paddygoat/Weather-Station/README.md

# Weather-Station
Low power LoRa weather station with 'professional' wind instruments

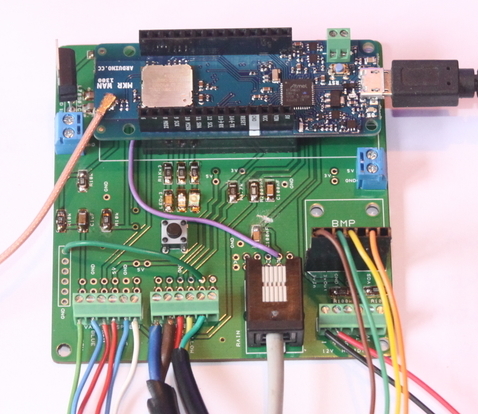
[picture p1: Arduino/weatherstation.jpg]

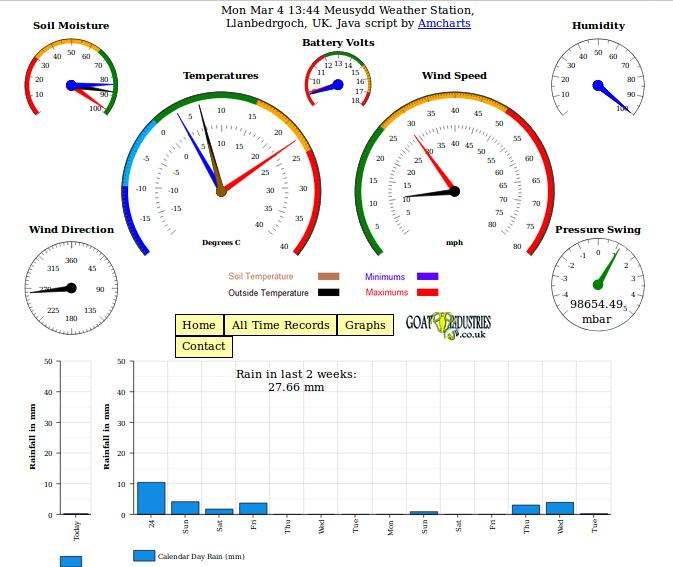
[picture p2: dials02.jpg]
