paddygoat/Weather-Station/PCB/README.md

.PCB file opens with 'Design Spark' software.

Weather station Tx can be used without Raspberry Pi or the Rx version if there is LoRa gateway in the locality.

The Rx PCB is for another Arduino 1300 LORAWAN that interfaces with 2G FONA module for Tx to interwebs.
