paddygoat/Weather-Station/server files/readMe.md

A web server with MYSQL and PHP capablities can be configured to present the GUI as seen at: 

http://www.goatindustries.co.uk/weather2/


Please check Amcharts license for terms of use.
