paddygoat/Weather-Station/server files/database_structure.png

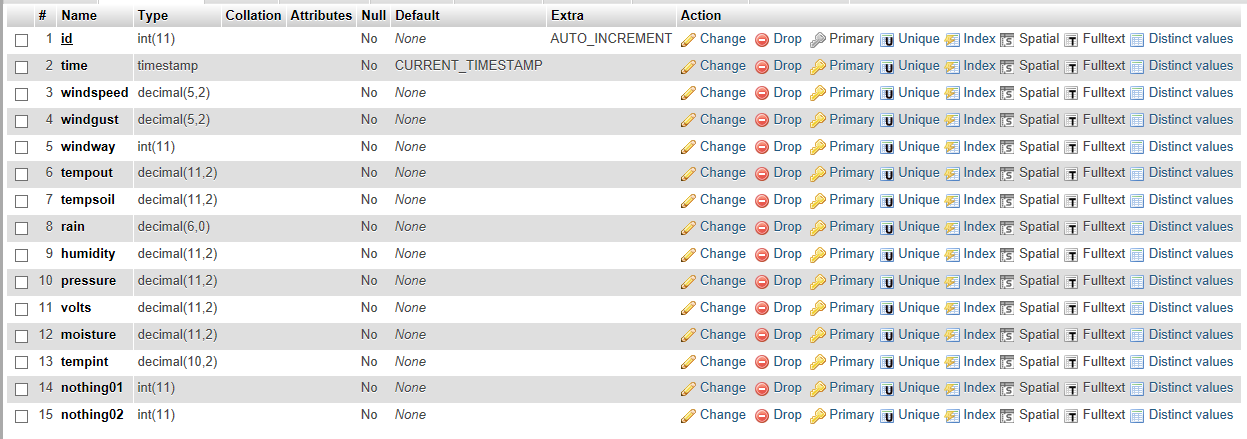
server files/database_structure.png
