paddygoat/Weather-Station/(threads)

Thread 1 (2020-11-11):

schematics

yanalp73, 2020-11-11:
Hello
Very interesting as a project
Is it possible to see the electronic diagram because I can only find the pcb
Thank you

gobotain, 2020-11-19:
Yes, pls make final version, incl schematics, bom etc.  Thanks

yanalp73, 2020-11-19:
Hello, where is the final version ? In PCB there is V4. But is only PCB, not schematics. Thanks

gobotain, 2020-11-19:
I'm looking at the commits on Arduino/Weather_station_V4.ino and some have/haven't been implemented in the .ino file.  Starting to lose faith in this project.

gobotain, 2020-11-20:
https://www.instructables.com/Arduino-GPRS-Weather-Station-Part-1/
