paddygoat/Weather-Station/(list of files, drawings)

Other design files:
PCB/Weather station 3_feather01.pcb
PCB/Weather station 3_Rx.pcb
PCB/Weather station 3_Tx.pcb
PCB/Weather station 4_feather01.pcb
PCB/Weather station 5 Heltech ESP32 LoRa.pcb
