paddygoat/Weather-Station/Arduino/windSpeed.cpp

#include <Arduino.h>
#include "counters.h"

unsigned long frequency;
float correction =0;
double runningTotal =0;

float knots =0.00;
float windSpeedValue =0.00;
float knotsMax =0.00;
float knotsAv =0.00;
float previousKnotsAv = 0.00;

float knotsDec =0.1;
float knotsMaxDec =0.1;
float knotsAvDec =0.1;

int frequencyInt;
int knotsInt;
int knotsAvInt;
int knotsMaxInt; 

int knotsDecInt;
int knotsMaxDecInt;
int knotsAvDecInt;

float previousKnots =0;
float calibration = 1.0047;    // (46.62 / 46.4)

float knotsRatio =0;
int error =0;
int zLog =0;
int windSpeedPin = 6;

void windSpeedSetup()
{

}
    
void windSpeed()
{
  //Serial.print(" ..pulseIn is next.. ");
  noInterrupts();                                                 // Stops rain guage from interupting pulsein.NB. The guage does poll twice.
  frequency = 500000/pulseIn(windSpeedPin,HIGH,500000);                     // was 5000000
  interrupts();
  if (frequency < 0){frequency=0;}    
  int correction =0;
  int adjustments();

  knots = (frequency * calibration /10) + correction + 0.1;
  windSpeedValue = knots;
  if (z==-1)
  {
    previousKnots = knots;
  }
  if (z==1)
  {
    zLog=0;
  }
  if ( z==25)
  {
    previousKnotsAv = knotsAv;                                                                // Helps filter work properly.
  }
  knotsRatio = knots/previousKnots;
  
  if( (previousKnots < 5) && (knotsRatio > 2.5) && (previousKnotsAv < 5) && (knots > 5) )                    // Filter out some weird readings at low speeds. PreviousK... used to be 3.
  {
    error =1;
    zLog = z;
    Serial.print("knots ratio:  ");Serial.print(knotsRatio);
    Serial.print("     knots:  ");Serial.print(knots);
    Serial.println("  ..... POSSIBLE ERROR DETECTED !! ..... NOW TRYING TO CORRECT.....");
    knots = previousKnots;
    Serial.print("     new knots:  ");Serial.print(knots);
    Serial.println("  .......... CORRECTED ??.....");
  }
  
  if(previousKnots < 5)
  {
    //delay(5000);                              // Allows pulseIn to catch up with itself? No - interfers with calback. 
  }
  previousKnots = knots;
  z++;
  

  if (knots > knotsMax)
  {
    knotsMax = knots;
  }
  
  runningTotal = runningTotal + knots;
  if(z==1)
  {
    runningTotal = knots;                              // Reset running total and max wind gust (knotsMax).
    knotsMax = knots;
  }
  
  knotsAv = runningTotal / z;
  if(knots > 0)
  {
    int beepFreq = ((int)knots * 10)+300;
    //Serial.print("beepFreq: ");Serial.println(beepFreq); 
    //tone(3,beepFreq,150);
  }
  Serial.print("Z: ");Serial.print(z);  
  Serial.print("    Knots: ");Serial.print(knots);
  Serial.print("    Knots ratio:  ");Serial.print(knotsRatio);
  Serial.print("    Previous knots av:  ");Serial.print(previousKnotsAv);
  //Serial.print("    Av wind speed: ");Serial.print(knotsAv);  
  Serial.print("    Max wind gust: ");Serial.print(knotsMax);   
  Serial.print("   LAST ERROR DETECTED at Z=  ");Serial.println(zLog);
  //Serial.print("   Running total: ");Serial.println(runningTotal);
  //Serial.print("Z: ");Serial.println(z);
}
void adjustments()
{   
    if ((frequency >=1) && (frequency <=100)) {correction = 0.20;}
    if ((frequency >100) && (frequency <=200)) {correction = 0.10;}
    if ((frequency >200) && (frequency <=300)) {correction = -0.25;}
    if ((frequency >300) && (frequency <=400)) {correction = -0.60;}
    if ((frequency >400) && (frequency <=500)) {correction = -1;}
    if ((frequency >500) && (frequency <=600)) {correction = -1.4;}
    if ((frequency >600) && (frequency <=700)) {correction = -1.75;}
    if ((frequency >700) && (frequency <=800)) {correction = -2;}
    if ((frequency >800) && (frequency <=900)) {correction = -2.20;}
    if ((frequency >900) && (frequency <=1000)) {correction = -2.35;}
    if ((frequency >1000) && (frequency <=1100)) {correction = -2.40;}
    if ((frequency >1100) && (frequency <=1200)) {correction = -2.50;}
    if ((frequency >1200) && (frequency <=1300)) {correction = -2.50;}
    if ((frequency >1300) && (frequency <=1400)) {correction = -2.50;}
    if ((frequency >1400) && (frequency <=1500)) {correction = -2.45;}
    if ((frequency >1500) && (frequency <=1600)) {correction = -2.40;}  
}
