paddygoat/Weather-Station/Glasshouse/batteryVolts.cpp

#include <Arduino.h>
#include "counters.h"

float volts=0;
float batteryVoltsValue =0;
float totalVolts;

//A3 is analogue in.

void batteryVolts()
{
    int sensorReading = analogRead(A3);
    batteryVoltsValue = sensorReading/28.81;
    //volts = analogRead(A3)/28.81;  
    //if (z>0)
    //{
    //  totalVolts = (totalVolts + volts);
    //  batteryVoltsValue = totalVolts/z;    
    //}
    //else
    //{
    //  batteryVoltsValue = volts;
    //}
    //Serial.print("Battery volts: ");Serial.println(batteryVoltsValue);
}
