paddygoat/Weather-Station/Glasshouse/BME280.h

#ifndef WEATHER_STATION_V3_BME280_H
#define WEATHER_STATION_V3_BME280_H

extern void BME280Readings();
extern void setupBME280();

extern float BME280Temperature;
extern float pressure;
extern float humidity;


#endif
