paddygoat/Weather-Station/Testing/OLED_LoRa_Receiver_03/images.h

#define logo_width 128
#define logo_height 53
const unsigned char logo_bits[] = {

0xff,0xff,0xff,0xff,0xff,0xff,0xff,0xff,0xff,0xff,0xff,0xff,0xff,0xff,0xff,0xff
,0xff,0xff,0xff,0xff,0xff,0xff,0xff,0xff,0xff,0xff,0xff,0xff,0xff,0xff,0xff,0xff
,0xff,0xff,0xff,0xff,0xff,0xff,0xff,0xff,0xff,0xff,0xff,0xff,0xff,0xff,0xff,0xff
,0xff,0xff,0xff,0xff,0xff,0xff,0xff,0xf8,0x07,0xff,0xff,0xff,0xff,0xff,0xff,0xff
,0xff,0xff,0xff,0xff,0xff,0xff,0xff,0xc0,0x00,0x7f,0xff,0xff,0xff,0xff,0xff,0xff
,0xff,0xff,0xff,0xff,0xff,0xff,0xff,0x00,0x00,0x1f,0xff,0xff,0xff,0xff,0xff,0xff
,0xff,0xff,0xff,0xff,0xff,0xff,0xfc,0x00,0x00,0x0f,0xff,0xff,0xff,0xff,0xff,0xff
,0xff,0xff,0xff,0xff,0xff,0xff,0xf8,0x00,0x00,0x07,0xff,0xff,0xff,0xff,0xff,0xff
,0xff,0xff,0xff,0xff,0xff,0xff,0xf0,0x00,0x00,0x03,0xff,0xff,0xff,0xff,0xff,0xff
,0xff,0xff,0xff,0xff,0xff,0xff,0xf0,0x00,0x00,0x01,0xff,0xff,0xff,0xff,0xff,0xff
,0xff,0xff,0xff,0xff,0xff,0xff,0xe0,0x00,0x00,0x01,0xff,0xff,0xff,0xff,0xff,0xff
,0xff,0xff,0xff,0xff,0xff,0xff,0xe0,0x00,0x00,0x00,0xff,0xff,0xff,0xff,0xff,0xff
,0xff,0xff,0xff,0xff,0xff,0xff,0xc0,0x00,0x00,0x00,0xff,0xff,0xff,0xff,0xff,0xff
,0xff,0xff,0xff,0xff,0xff,0xff,0xc0,0x00,0x00,0x00,0xff,0xff,0xff,0xff,0xff,0xff
,0xff,0xff,0xff,0xff,0xff,0xff,0xc0,0x00,0x00,0x00,0xff,0xff,0xff,0xff,0xff,0xff
,0xff,0xff,0xff,0xff,0xff,0xff,0xe0,0x00,0x00,0x02,0xff,0xff,0xff,0xff,0xff,0xff
,0xff,0xff,0xff,0xff,0xff,0xff,0xf0,0x00,0x00,0x01,0xff,0xff,0xff,0xff,0xff,0xff
,0xff,0xff,0xff,0xff,0xff,0xff,0xe3,0xfc,0x0f,0xf1,0xff,0xff,0xff,0xff,0xff,0xff
,0xff,0xff,0xff,0xff,0xff,0xff,0xe7,0xfe,0x1f,0xf9,0xff,0xff,0xff,0xff,0xff,0xff
,0xff,0xff,0xff,0xff,0xff,0xff,0xe7,0xff,0x1f,0xf9,0xff,0xff,0xff,0xff,0xff,0xff
,0xff,0xff,0xff,0xff,0xff,0xff,0xe7,0xff,0x1f,0xf9,0xff,0xff,0xff,0xff,0xff,0xff
,0xff,0xff,0xff,0xff,0xff,0xff,0xf3,0xfe,0x1f,0xf9,0xff,0xff,0xff,0xff,0xff,0xff
,0xff,0xff,0xff,0xff,0xff,0xe3,0xf3,0xf8,0xe7,0xf1,0xff,0xff,0xff,0xff,0xff,0xff
,0xff,0xff,0xff,0xff,0xff,0xc0,0xe0,0x01,0xf0,0x01,0xf0,0xff,0xff,0xff,0xff,0xff
,0xff,0xff,0xff,0xff,0xff,0xc0,0x60,0x03,0xf0,0x01,0xe0,0xff,0xff,0xff,0xff,0xff
,0xff,0xff,0xff,0xff,0xff,0x80,0x30,0x03,0xf0,0x01,0x80,0x7f,0xff,0xff,0xff,0xff
,0xff,0xff,0xff,0xff,0xff,0x00,0x38,0x83,0xf0,0x43,0x80,0x3f,0xff,0xff,0xff,0xff
,0xff,0xff,0xff,0xff,0xff,0x00,0x1f,0x81,0x20,0x7f,0x00,0x3f,0xff,0xff,0xff,0xff
,0xff,0xff,0xff,0xff,0xff,0x00,0x0f,0xc0,0x00,0xfe,0x00,0x3f,0xff,0xff,0xff,0xff
,0xff,0xff,0xff,0xff,0xff,0x80,0x03,0xe0,0x00,0xfc,0x00,0x3f,0xff,0xff,0xff,0xff
,0xff,0xff,0xff,0xff,0xff,0xc0,0x01,0xfc,0x07,0xf0,0x00,0x7f,0xff,0xff,0xff,0xff
,0xff,0xff,0xff,0xff,0xff,0xff,0xc0,0x71,0x69,0xe0,0x1f,0xff,0xff,0xff,0xff,0xff
,0xff,0xff,0xff,0xff,0xff,0xff,0xf0,0x3c,0x0f,0x80,0xff,0xff,0xff,0xff,0xff,0xff
,0xff,0xff,0xff,0xff,0xff,0xff,0xfc,0x0f,0xff,0x07,0xff,0xff,0xff,0xff,0xff,0xff
,0xff,0xff,0xff,0xff,0xff,0xff,0xff,0x03,0xfc,0x1f,0xff,0xff,0xff,0xff,0xff,0xff
,0xff,0xff,0xff,0xff,0xff,0xff,0xff,0xc0,0xf0,0x3f,0xff,0xff,0xff,0xff,0xff,0xff
,0xff,0xff,0xff,0xff,0xff,0xff,0xff,0xf0,0x00,0xff,0xff,0xff,0xff,0xff,0xff,0xff
,0xff,0xff,0xff,0xff,0xff,0xff,0xff,0xfc,0x03,0xff,0xff,0xff,0xff,0xff,0xff,0xff
,0xff,0xff,0xff,0xff,0xff,0xff,0xff,0xf8,0x01,0xff,0xff,0xff,0xff,0xff,0xff,0xff
,0xff,0xff,0xff,0xff,0xff,0xff,0xff,0xc0,0x00,0x3f,0xff,0xff,0xff,0xff,0xff,0xff
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
};
