paddygoat/Weather-Station/(commit log)

2019-01-15 Create Raspberry Pi LoRa Reciever
2019-01-23 filter out non ASC11 characters from payload (0 to 127 are kept)
2019-01-25 Fix 'Too many files' SPI error.
    [main.c]
2019-01-26 Adjust low speed error filter
    [windSpeed.cpp]
2019-01-29 make volts sensing work
2019-01-31 Adjust windspeed filter threshold
    Adjust windspeed filter threshold from 3 to 5 knots
2019-02-05 filter improved and interrupt conflict
    windspeed filter improved and making windspeed readings go quite during callback period to avoid possible interrupt conflicts.
    [windSpeed.cpp]
2019-02-06 Add watch dog timer
    [Weather station 3_Tx.pcb]
2019-02-06 Swap out FONA 800H to Feather
    [Weather station 3_Rx.pcb]
2019-02-09 Shorten Track lengths
    Pathways to the MCU are shortened and the wind speed track made as direct as possible to help prevent errors. All pin numbers are changed, so the current code (09/02/2019) will no longer work until PCBs arrive and are tested.
    [Weather station 3_Tx.pcb]
2019-02-17 fix security hole
2019-02-28 Change to PCB v3.03
2019-02-28 Correct missing track on soil temp
    [Weather station 3_Tx.pcb]
2019-03-01 Activate appropriate pins for power and sense
2019-03-05 Add switch on reset
    [Weather station 3_Tx.pcb]
2019-03-15 Fix analogue read bug
    use int to read analogue pin, not float.
    [batteryVolts.cpp]
2019-04-15 PCB for Adafruit Feather M0 RFM95 LoRa Radio 3178
    [Weather station 3_feather01.pcb]
2019-04-30 Add diode, change rain gauge capacitor value.
    [Weather station 4_feather01.pcb]
